yusufdxb/EcoSort-bin/hardware/README.md

## Hardware Design

This folder documents the physical implementation of EcoSort.

### Included
- Sensor wiring diagrams
- Mechanical sketches and 3D designs
- Servo and load cell mounting strategy
- Power distribution notes

The prototype uses a seesaw-style intake platform driven by a
high-torque servo motor to direct waste into the correct compartment.
