yusufdxb/EcoSort-bin/(commit log)

2026-01-12 Add EcoSort Arduino firmware
2026-03-23 Add auditable results scaffold
    [trial_log_template.csv]
2026-03-23 Tighten README wording
2026-03-23 Revert doc rewrite artifacts
    [trial_log_template.csv]
2026-03-23 eval: add confusion matrix script and trial results template
    - evaluation/confusion_matrix.py: reads trial CSV, outputs 2x2 matrix + Wilson 95% CI
    - evaluation/trial_results_template.csv: structured template (trial_id, sensors, classes, excluded flag)
    - evaluation/results/.gitkeep: tracks results directory
    [trial_results_template.csv]
2026-03-28 chore: add .gitattributes with linguist overrides for Arduino code
2026-06-21 chore: add .gitignore for Arduino build artifacts and IDE files
