yusufdxb/EcoSort-bin/(notices)

Notices in the files:
README.md:
License: MIT
